emintz/FirstRobotics/PracticeFieldTimer/PracticeFieldTimer-38-pin-ESP32s2/README.md

# Generic 38 Pin ESP32 Development Board Based Countdown Timer

:warning: **DEPRECATED** :warning:

This design is deprecated and scheduled for removal. Favor the current
[ESP32 DevKitC-based](https://github.com/emintz/FirstRobotics/tree/main/PracticeFieldTimerV2)
configuration.
