emintz/FirstRobotics/PracticeFieldTimerV2/README.md

# Metuchen Momentum Countdown Timer

## License

The countdown timer hardware design is made available subject to the terms of the
CERN Open Hardware Licence Version 2 - Strongly Reciprocal. A copy should have been
provided to you. If you have not been provided with a copy, you can download one from
https://cern-ohl.web.cern.ch/ pdf
[pdf](https://gitlab.com/ohwr/project/cernohl/-/wikis/uploads/b236492596cfc91c12def7d50bbf7da0/cern_ohl_s_v2.pdf)
or
[plain text](https://gitlab.com/ohwr/project/cernohl/-/wikis/uploads/819d71bea3458f71fba6cf4fb0f2de6b/cern_ohl_s_v2.txt)
format.

## Background

The printed circuit board is a follow-on project to the prototype
countdown timer used to manage the practice field during the 2026
FIRST Mid-Atlantic championship competition. Everyone involved
considered it successful. The prototypes were immature, far too
fragile to withstand routine handling during transportation and
storage. It is hoped that the printed circuit board-based design
will meet this need.
