emintz/FirstRobotics/PracticeFieldTimerV2/PracticeFieldTimerV2.kicad_pcb

## KiCad design PracticeFieldTimerV2/PracticeFieldTimerV2.kicad_pcb (2026-06-14, an earlier design)

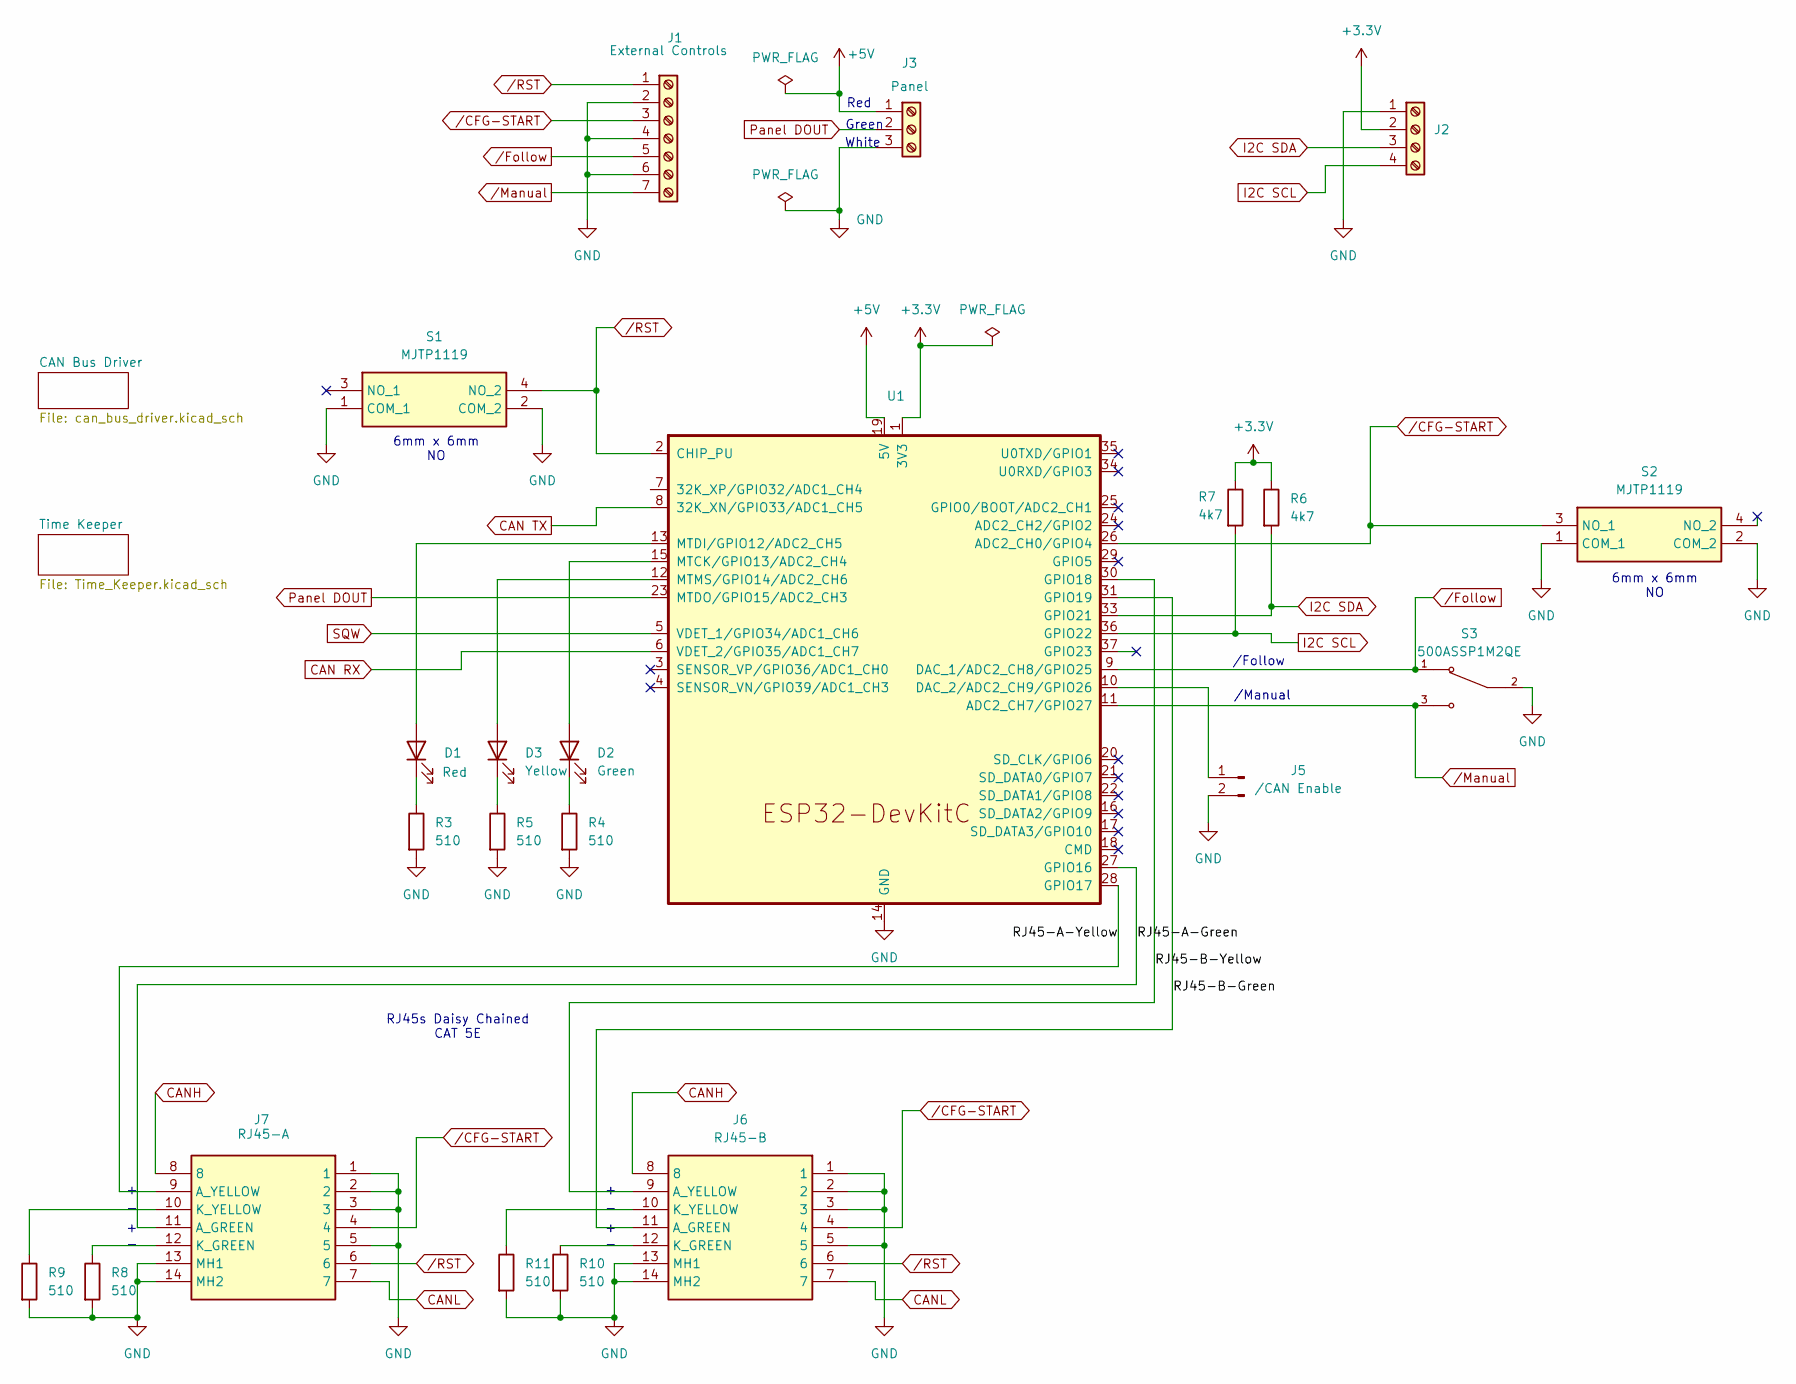
[picture p1: schematic PracticeFieldTimerV2.kicad_sch, Practice Field Timer V2 (surface mount)]

Parts:
D1: Red; LED_D5.0mm-PCBWay-Compatible
D2: Green; LED_D5.0mm-PCBWay-Compatible
D3: Yellow; LED_D5.0mm-PCBWay-Compatible
J1: External Controls; TerminalBlock_MaiXu_MX126-5.0-07P_1x07_P5.00mm
J2: Screw_Terminal_01x04; TerminalBlock_MaiXu_MX126-5.0-04P_1x04_P5.00mm
J3: Panel; TerminalBlock_MaiXu_MX126-5.0-03P_1x03_P5.00mm
J5: /CAN Enable; PinHeader_1x02_P2.54mm_Vertical
J6: RJ45-B; MTJ88TX1FSDLG; Manufacturer_Part_Number MTJ-88TX1-FSD-LG; Mouser Part Number 737-MTJ-88TX1-FSD-LG
J7: RJ45-A; MTJ88TX1FSDLG; Manufacturer_Part_Number MTJ-88TX1-FSD-LG; Mouser Part Number 737-MTJ-88TX1-FSD-LG
R3, R4, R5, R8, R9, R10, R11: 510; R_Axial_DIN0207_L6.3mm_D2.5mm_P15.24mm_Horizontal
R6, R7: 4k7; R_Axial_DIN0207_L6.3mm_D2.5mm_P15.24mm_Horizontal
S1, S2: MJTP1119; Manufacturer_Part_Number MJTP1119; Mouser Part Number 642-MJTP1119
S3: 500ASSP1M2QE; SW_500ASSP1M2QE; PARTREV G
U1: ESP32-DevKitC

Connections:
+3.3V: J2.2, R6.1, R7.1, U1.1 (3V3); also elsewhere on the board
+5V: J3.1, U1.19 (5V)
/RJ45-A-Green: J7.11 (A_GREEN), U1.27 (GPIO16)
/RJ45-A-Yellow: J7.9 (A_YELLOW), U1.28 (GPIO17)
/RJ45-B-Green: J6.11 (A_GREEN), U1.31 (GPIO19)
/RJ45-B-Yellow: J6.9 (A_YELLOW), U1.30 (GPIO18)
CAN RX: U1.6 (VDET_2/GPIO35/ADC1_CH7); also elsewhere on the board
CAN TX: U1.8 (32K_XN/GPIO33/ADC1_CH5); also elsewhere on the board
CANH: J6.8, J7.8; also elsewhere on the board
CANL: J6.7, J7.7; also elsewhere on the board
GND: J1.2, J1.4, J1.6, J2.1, J3.3, J5.2, J6.1, J6.2, J6.3, J6.5, J6.13 (MH1), J6.14 (MH2), J7.1, J7.2, J7.3, J7.5, J7.13 (MH1), J7.14 (MH2), R3.2, R4.2, R5.2, R8.2, R9.2, R10.2, R11.2, S1.1 (COM_1), S1.2 (COM_2), S2.1 (COM_1), S2.2 (COM_2), S3.2, U1.14 (GND), U1.32 (GND), U1.38 (GND); also elsewhere on the board
I2C SCL: J2.4, R7.2, U1.36 (GPIO22); also elsewhere on the board
I2C SDA: J2.3, R6.2, U1.33 (GPIO21); also elsewhere on the board
unnamed: D1.2 (A), U1.13 (MTDI/GPIO12/ADC2_CH5)
unnamed: D1.1 (K), R3.1
unnamed: D2.2 (A), U1.15 (MTCK/GPIO13/ADC2_CH4)
unnamed: D2.1 (K), R4.1
unnamed: D3.2 (A), U1.12 (MTMS/GPIO14/ADC2_CH6)
unnamed: D3.1 (K), R5.1
unnamed: J5.1, U1.10 (DAC_2/ADC2_CH9/GPIO26)
unnamed: J6.12 (K_GREEN), R10.1
unnamed: J6.10 (K_YELLOW), R11.1
unnamed: J7.12 (K_GREEN), R8.1
unnamed: J7.10 (K_YELLOW), R9.1
Panel DOUT: J3.2, U1.23 (MTDO/GPIO15/ADC2_CH3)
SQW: U1.5 (VDET_1/GPIO34/ADC1_CH6); also elsewhere on the board
/CFG-START: J1.3, J6.4, J7.4, S2.3 (NO_1), U1.26 (ADC2_CH0/GPIO4)
/Follow: J1.5, S3.1, U1.9 (DAC_1/ADC2_CH8/GPIO25)
/Manual: J1.7, S3.3, U1.11 (ADC2_CH7/GPIO27)
/RST: J1.1, J6.6, J7.6, S1.4 (NO_2), U1.2 (CHIP_PU)

Notes on the sheet:
Red
6mm x 6mm NO
Green
White
/Manual
/Follow
RJ45s Daisy Chained CAT 5E

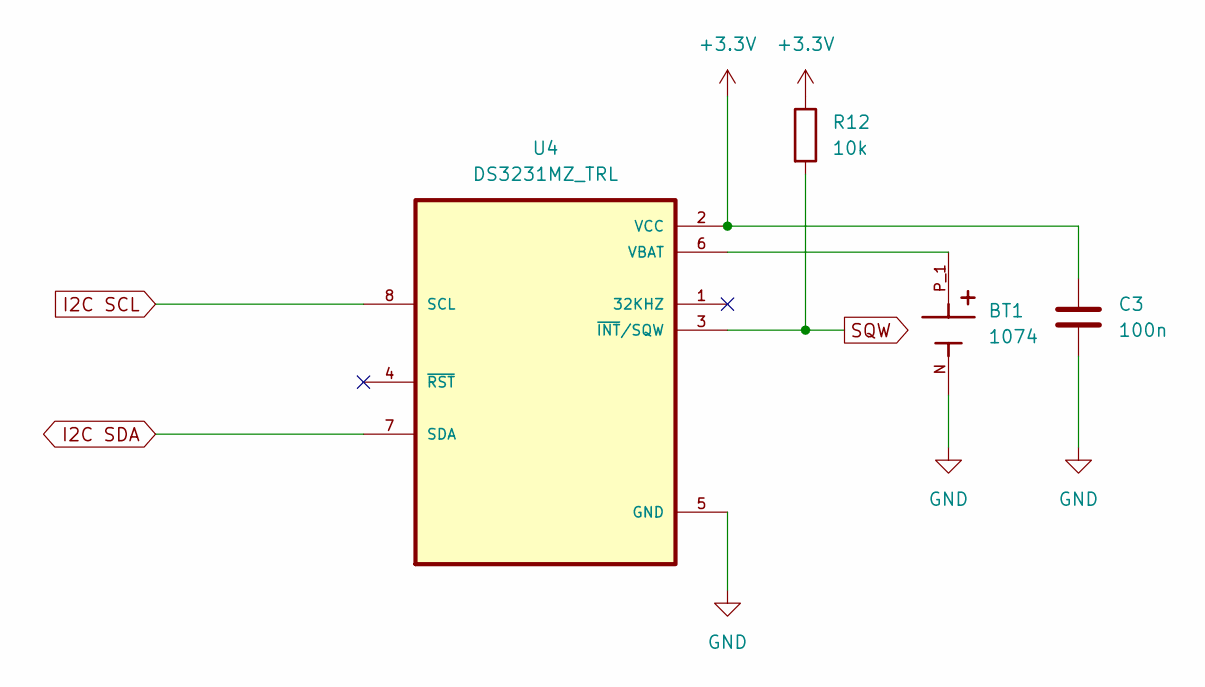
[picture p2: schematic Time_Keeper.kicad_sch, Practice Field Timer V2 (surface mount)]

Parts:
BT1: 1074; BAT_1074; PARTREV B
C3: 100n; C_Disc_D5.0mm_W2.5mm_P5.00mm
R12: 10k; R_Axial_DIN0207_L6.3mm_D2.5mm_P15.24mm_Horizontal
U4: DS3231MZ_TRL; 21-0041B_8_MXM

Connections:
+3.3V: C3.1, R12.1, U4.2 (VCC); also elsewhere on the board
GND: BT1.N, C3.2, U4.5 (GND); also elsewhere on the board
I2C SCL: U4.8 (SCL); also elsewhere on the board
I2C SDA: U4.7 (SDA); also elsewhere on the board
unnamed: BT1.P_1, BT1.P_2, U4.6 (VBAT)
SQW: R12.2, U4.3 (~INT/SQW); also elsewhere on the board

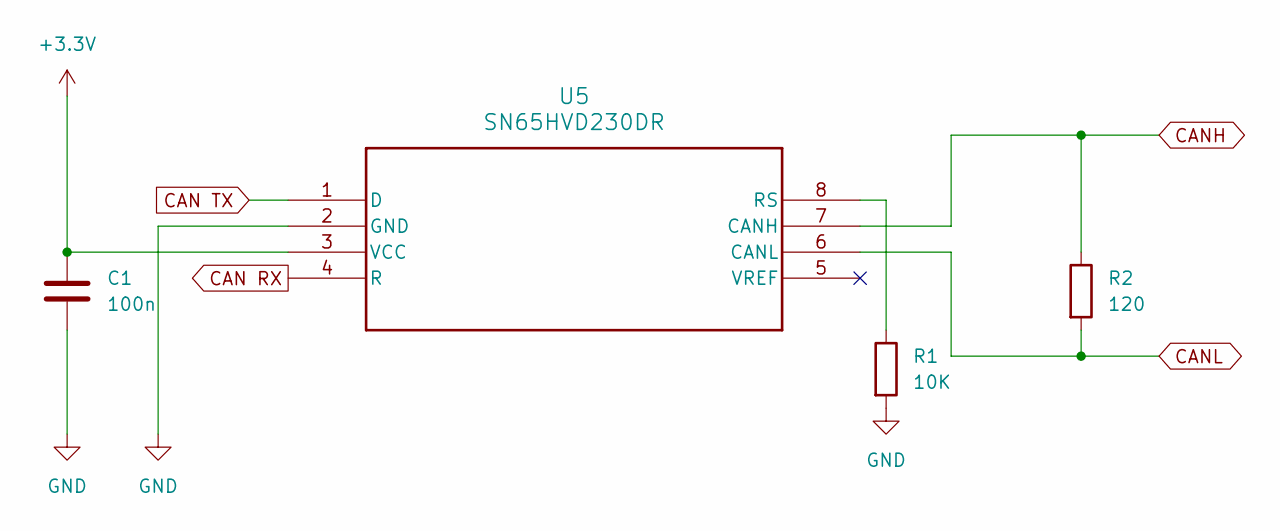
[picture p3: schematic can_bus_driver.kicad_sch, Practice Field Timer V2 (surface mount)]

Parts:
C1: 100n; C_Disc_D5.0mm_W2.5mm_P5.00mm
R1: 10K; R_Axial_DIN0207_L6.3mm_D2.5mm_P15.24mm_Horizontal
R2: 120; R_Axial_DIN0207_L6.3mm_D2.5mm_P15.24mm_Horizontal
U5: SN65HVD230DR

Connections:
+3.3V: C1.1, U5.3 (VCC); also elsewhere on the board
CAN RX: U5.4 (R); also elsewhere on the board
CAN TX: U5.1 (D); also elsewhere on the board
CANH: R2.1, U5.7 (CANH); also elsewhere on the board
CANL: R2.2, U5.6 (CANL); also elsewhere on the board
GND: C1.2, R1.2, U5.2 (GND); also elsewhere on the board
unnamed: R1.1, U5.8 (RS)

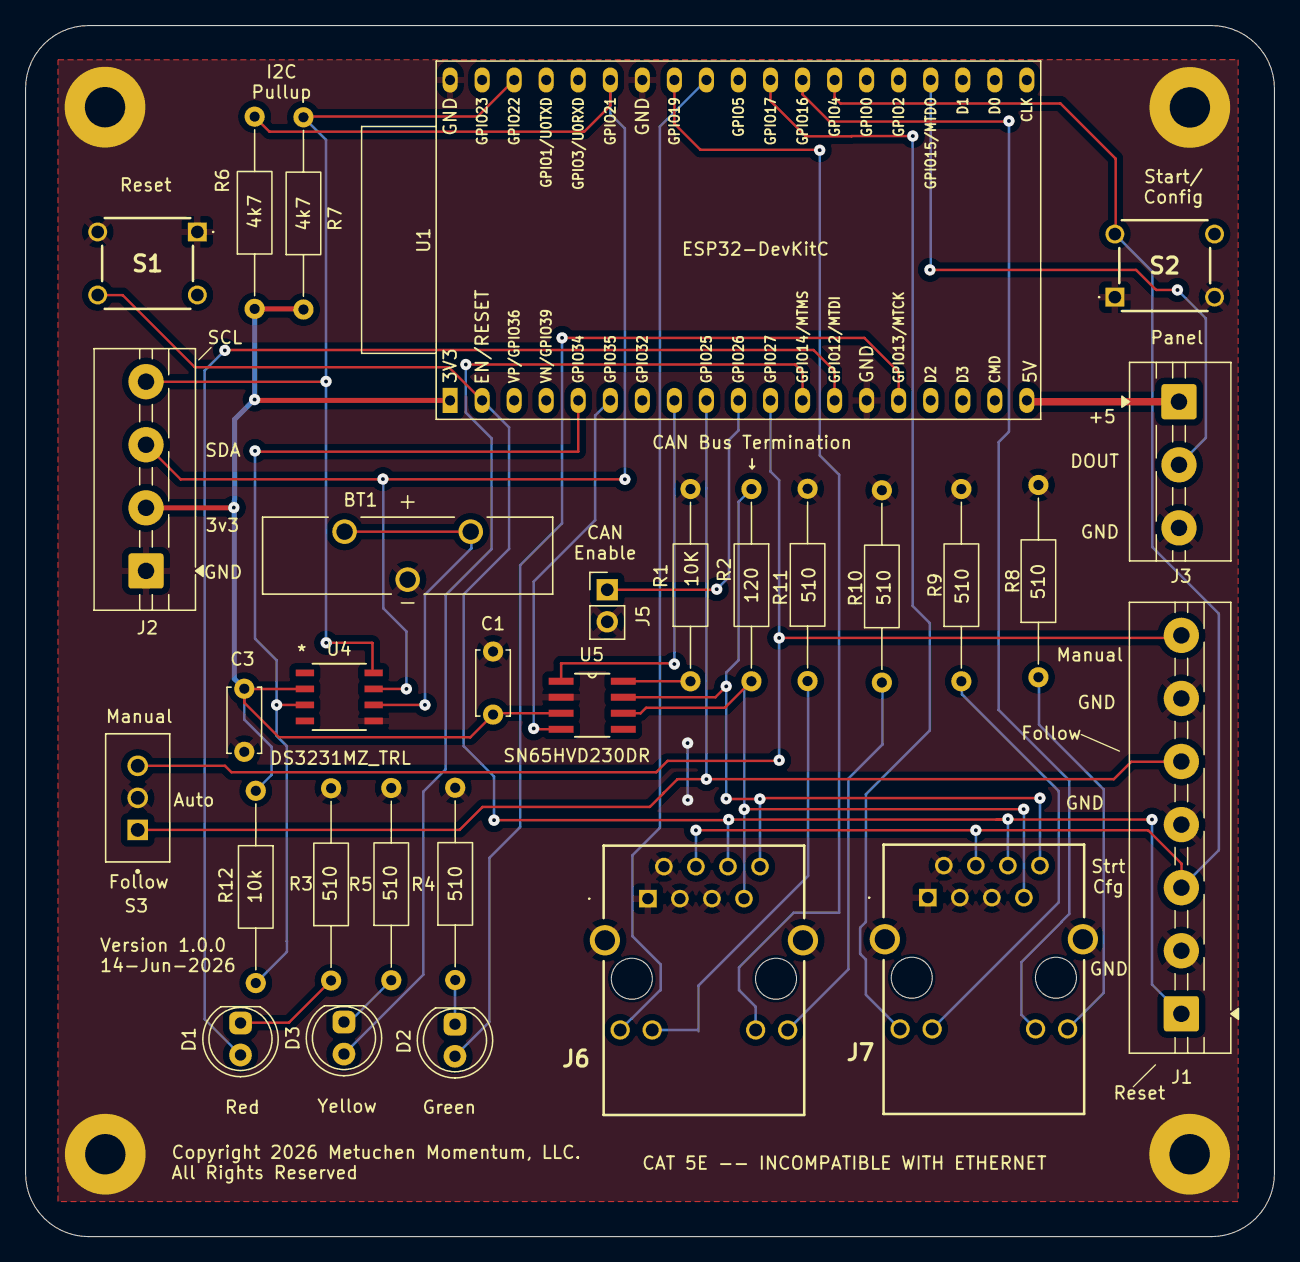
[picture p4: board PracticeFieldTimerV2.kicad_pcb from above]

Board: 2 copper layers, 99.0 x 96.0 mm, 36 parts (1 on the bottom side), 32 nets.

Other parts of the board:
Logo80%: LOGO; MetuchenMomentumLogo80Percent
MH1, MH2, MH3, MH4: MountingHole_3.2mm_M3_Pad_TopBottom_Grounded
MH3#2: (no value)

Their connections:
GND: MH1.1, MH2.2, MH3.3, MH3#2.3, MH4.4; also elsewhere on the board
