emintz/FirstRobotics/PracticeFieldTimer/src/PracticeFieldTimer.ino

/*
 * PracticeFieldTimer.ino
 *
 *  Created on: Apr 26, 2025
 *      Author: Eric Mintz
 *
 * Main program for the FIRST Robotics competition practice field.
 *
 * Copyright (C) 2025 Eric Mintz
 * All Rights Reserved
 *
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
 * You should have received a copy of the GNU Affero General Public License
 * along with this program.  If not, see <https://www.gnu.org/licenses/>.
 */
#include "Arduino.h"

#include "BlinkErrorCodes.h"
#include "CanBus.h"
#include "CANDisplayCommandPublisher.h"
#include "CanEnumerations.h"
#include "Configurator.h"
#include "ConfigurationCancelledPage.h"
#include "ContinuousCountdown.h"
#include <DataTypeCharacteristics.h>
#include "DataTypes.h"
#include "DisplayCommand.h"
#include "DS3231TimeSource.h"
#include "ErrorHalt.h"
#include "Flash32.h"
#include "ManualCountdown.h"
#include "OneShotBlink.h"
#include "PanelServer.h"
#include "PinAssignments.h"
#include "PressAndHold.h"
#include "PullQueueHT.h"
#include <SetBlankValue.h>
#include "StatusLcd.h"
#include "TaskPriorities.h"
#include "TaskWithActionH.h"
#include "TextDisplay.h"
#include "TimeChangeHandler.h"
#include "TimeRequestHandlers.h"
#include "WebServer.h"
#include "WS2812B8x32vertical.h"

#include <LiquidCrystal_I2C.h>
#include <WiFi.h>
#include <Wire.h>

#include <hal/efuse_hal.h>

// Status LCD configuration
#define LCD_ADDRESS 0x27
#define LCD_COLUMNS 20
#define LCD_ROWS 4

// User must press and hold the configuration reset button
// for three seconds within 5 seconds after power on.
#define PRESS_TIMEOUT_MS 3000
#define PRESS_WINDOW_MS 5000

// Bitmap representing "CONFIG" to be displayed
// when the web page is active.
static constexpr const uint8_t config_bitmap[] = {
//  Bits        Column
//  ----------- ------
    0b00000000, //  0

    // C
    0b01111110, //  1
    0b10000001, //  2
    0b10000001, //  3
    0b10000001, //  4
    0b01000010, //  5
    0b00000000, //  6

    // O
    0b01111110, //  7
    0b10000001, //  8
    0b10000001, //  9
    0b10000001, // 10
    0b01111110, // 11
    0b00000000, // 12

    // N
    0b11111111, // 13
    0b01000000, // 14
    0b00100000, // 15
    0b00010000, // 16
    0b11111111, // 17
    0b00000000, // 18

    // F
    0b11111111, // 19
    0b10010000, // 20
    0b10010000, // 21
    0b10010000, // 22
    0b10000000, // 23
    0b00000000, // 24

    // I
    0b11111111, // 25
    0b00000000, // 26

    // G
    0b01111110, // 27
    0b10000001, // 28
    0b10010001, // 29
    0b10010001, // 30
    0b01001110, // 31
};

// Bitmap spelling SETUP, to be displayed at power on
const uint8_t setup_bitmap[] = {
//  Bits        Column
//  ----------- ------
    0b00000000, //  0
    0b00000000, //  1

    // S
    0b01100010, //  2
    0b10010001, //  3
    0b10010001, //  4
    0b10010001, //  5
    0b01001110, //  6
    0b00000000, //  7

    // E
    0b11111111, //  8
    0b10010001, //  9
    0b10010001, // 10
    0b10010001, // 11
    0b10000001, // 12
    0b00000000, // 13

    // T
    0b10000000, // 14
    0b10000000, // 15
    0b11111111, // 16
    0b10000000, // 17
    0b10000000, // 18
    0x00000000, // 19

    // U
    0b11111110, // 20
    0b00000001, // 21
    0b00000001, // 22
    0b00000001, // 23
    0b11111110, // 24
    0b00000000, // 25

    // P
    0b11111111, // 26
    0b10010000, // 27
    0b10010000, // 28
    0b10010000, // 29
    0b01100000, // 30
    0b00000000, // 31
};

// Bitmap spelling WAIT, to be displayed after the user
// finishes configuring the timer
static constexpr const uint8_t wait_bitmap[] = {
//  Bits        Column
//  ----------- ------
    0b00000000, //  0
    0b00000000, //  1
    0b00000000, //  2
    0b00000000, //  3
    0b00000000, //  4
    0b00000000, //  5

    // W
    0b11111111, //  6
    0b00000010, //  7
    0b00000100, //  8
    0b00000010, //  9
    0b11111111, // 10
    0b00000000, // 11

    // A
    0b00111111, // 12
    0b01001000, // 13
    0b10001000, // 14
    0b01001000, // 15
    0b00111111, // 16
    0b00000000, // 17

    // I
    0b11111111, // 18
    0b00000000, // 19

    // T
    0b10000000, // 20
    0b10000000, // 21
    0b11111111, // 22
    0b10000000, // 23
    0b10000000, // 24
    0b00000000, // 25

    0b00000000, // 26
    0b00000000, // 27
    0b00000000, // 28
    0b00000000, // 29
    0b00000000, // 30
    0b00000000, // 31

};

// WiFi access point configuration
static constexpr const char *ssid = "FieldTimer";
static constexpr const char *password = "FirstRobotics";
static const IPAddress local_ip(192, 168, 251, 4);
static const IPAddress gateway(192, 168, 251, 1);
static const IPAddress subnet(255, 255, 255, 0);

// Status LCD support
static LiquidCrystal_I2C lcd(LCD_ADDRESS, LCD_COLUMNS, LCD_ROWS);
static StatusLcd status_display(lcd);

// Blinkenlights on the RJ-45 sockets
static PullQueueHT<OneShotBlinkCommand> rj45_blink_queue(3);
static OneShotBlink rj45_blink(rj45_blink_queue);
static TaskWithActionH rj45_blink_task(
    "RJ45 Blink",
    RJ45_BLINK_PRIORITY,
    &rj45_blink,
    4096);

// Time configuration.
static int32_t reference_time_utc = 0;
static int32_t auto_field_time_minutes = 0;
static int32_t manual_field_time_minutes = 0;

static int16_t time_remaining = 0;

/*
 * We want the time display to turn gradually from blue to
 * red as time elapses. We want the display to be completely
 * red for the last minute. setup() will set these constants
 * to enable this.
 */
static int16_t all_red_period = 60;

static constexpr const char *nvs_namespace = "field-timer";

static DS3231_TimeSource ds3231;
static PullQueueHT<DisplayCommand> command_queue(4);
static WS2812B8x32vertical panel;
static PanelServer server(command_queue, panel, status_display);
static TaskWithActionH server_task(
    "Panel",
    PANEL_PRIORITY,
    &server,
    4096);

static std::unique_ptr<ContinuousCountdown> continuous_count_down;
static std::unique_ptr<ManualCountdown> manual_count_down;

static TimeChangeHandler incoming_time_change_handler(
    command_queue,
    rj45_blink_queue);
static CanBus can_bus(CAN_RECEIVE_PIN, CAN_TRANSMIT_PIN, CanBusSpeed::BPS_100K);
static CANDisplayCommandPublisher to_can_bus(can_bus);
static WebServer web_server;

static void start_rj45_blink(void) {
  Serial.println("Starting RJ45 LED blink task.");
  if (rj45_blink_queue.begin()
      && rj45_blink_task.start()) {
    Serial.println("RJ45 LED blink task started.");
    return;
  }
  ErrorHalt::halt_and_catch_fire(
      RJ45_BLINK_START_FAILED,
      "RJ45 blink task start failed");
}

/**
 * Prints chip characteristics -- helpful for debugging.
 */
static void show_machine_characteristics(void) {
  uint8_t mac_address[8];
  memset(mac_address, 0, sizeof(mac_address));
  Serial.printf(
      "Chip version: %u.\n", efuse_hal_chip_revision());
  Serial.printf(
      "Block version: %u.\n", efuse_hal_blk_version());
  Serial.printf(
      "ESP32 model: %s.\n", ESP.getChipModel());
  Serial.printf(
      "The chip has %u cores.\n", ESP.getChipCores());
  efuse_hal_get_mac(mac_address);
  Serial.printf(
      "MAC address: %02x:%02x:%02x:%02x:%02x:%02x.\n",
      mac_address[0],
      mac_address[1],
      mac_address[2],
      mac_address[3],
      mac_address[4],
      mac_address[5]);
}

/**
 * Query the I2C bus for a device at the specified address on Wire
 * (bus 0).
 *
 * Parameters:
 * ----------
 *
 * Name                 Contents
 * -----------------    ------------------------------------------------
 * address              I2C address to probe
 *
 * Returns: true if an I2C device responds, false otherwise
 */
static bool have_i2c_device(uint8_t address) {
  Wire.beginTransmission(address);
  auto error = Wire.endTransmission();
  if (error == 4) {
    Serial.printf("Unknown error at 0x%2x(%d)\n",
        address, address);
  }
  return !error;
}

/**
 * Sense all attached I2C devices. The method probes the
 * bus at all valid addresses.
 */
static void scan_i2c_bus(void) {
  Serial.println("Scanning I2C bus...");
  for (uint8_t address = 1; address < 127; address++) {
    if (have_i2c_device(address)) {
      Serial.printf("I2C device found at: 0x%02x (%d decimal).\n",
          static_cast<int>(address), static_cast<int>(address));
    }
  }
  Serial.println("I2C bus scan completed.");
}

/*
 * Raises and lowers a GPIO pin 4 times/second for one second.
 * This is used during startup.
 *
 * Parameters:
 * ----------
 *
 * Name                 Contents
 * -----------------    ------------------------------------------------
 * pin                  GPIO pin to blink.
 */
static void blink_it(int pin_no) {
  for (int i = 0; i < 4; ++i) {
    digitalWrite(pin_no, HIGH);
    vTaskDelay(pdMS_TO_TICKS(125));
    digitalWrite(pin_no, LOW);
    vTaskDelay(pdMS_TO_TICKS(125));
  }
}

/*
 * Configure and turn on WIFI as an access point. This is used during
 * configuration.
 */
static void wifi_on(void) {
  if (!WiFi.mode(WIFI_AP) || !WiFi.begin(ssid, password)) {
    ErrorHalt::halt_and_catch_fire(
        WIFI_ACCESS_POINT_SETUP_FAILED,
        "Could not configure WIFI as an access_point");
  }
  if (!WiFi.softAPConfig(local_ip, gateway, subnet)) {
    ErrorHalt::halt_and_catch_fire(
        WIFI_IP_SETUP_FAILED,
        "Could not configure WIFI IP address.");
  }
}

static void clear_panel(void) {
  DisplayCommand command;
  memset(&command, 0, sizeof(command));
  command.command = DisplayCommand::Pattern::FLOOD;
  command_queue.send_message(&command);
}

static void show_wifi_setup(void) {
  status_display.clear();
  status_display.ssid(WiFi.softAPSSID().c_str());
  status_display.password(password);
  status_display.url_path(local_ip.toString().c_str());
}

/*
 * Read the configuration parameter values from the web
 * service and persist them in NVS.
 */
static void set_configuration_parameters(void) {
  digitalWrite(GREEN_LED_PIN, HIGH);
  digitalWrite(YELLOW_LED_PIN, HIGH);
  TimeRequestHandlers set_time(ds3231);
  web_server.addHandler(&set_time);
  Configurator configurator(nvs_namespace);
  std::map<const std::string, std::string> submit_attributes;
  DataTypes data_types;
  configurator
      .add_field(
          "ref-time",
          "Auto Mode Reference Time (24 Hour UTC)",
          data_types.int32)
      .add_field(
          "auto-time",
          "Auto Mode Cycle Time (Minutes)",
          data_types.int32)
      .add_field(
          "manual-time",
          "Manual Mode Cycle Time (Minutes)",
          data_types.int32);
  if (!configurator.run(web_server, "/configure-sessions")) {
    ErrorHalt::halt_and_catch_fire(
        SYSTEM_NOT_CONFIGURED,
        "Timer configuration failed.");
  }
  digitalWrite(GREEN_LED_PIN, LOW);
  digitalWrite(YELLOW_LED_PIN, LOW);
}

/*
 * Turn WiFi off -- called when configuration is complete..
 */
static void wifi_off(void) {
  if (!WiFi.mode(WIFI_OFF)) {
    ErrorHalt::halt_and_catch_fire(
        WIFI_SHUTDOWN_FAILED, "Could not turn WIFI off.");
  }
}

/*
 * Enable the configuration setup web page if the user
 * requests it by pressing and holding the
 * SET_CONFIGURATION_PIN (see PinAssignments.h) during
 * startup.
 */
static void configure_if_requested(void) {
  Serial.println("Checking for configuration request.");
  PressAndHold configuration_signal(
      SET_CONFIGURATION_PIN,
      PRESS_TIMEOUT_MS,
      PRESS_WINDOW_MS);
  if (configuration_signal.wait_for_press_and_hold()) {
    TextDisplay display;
    display(config_bitmap, {0, 0, 63}, panel);
    Serial.println("Configuring ...");
    wifi_on();
    digitalWrite(BUILTIN_LED_PIN, HIGH);
    show_wifi_setup();
    set_configuration_parameters();
    display(wait_bitmap, {31, 31, 0}, panel);
    status_display.clear();
    vTaskDelay(pdMS_TO_TICKS(2000));
    digitalWrite(BUILTIN_LED_PIN, LOW);
    wifi_off();
    panel.clear();
    Serial.println("Configuration complete.");
  } else {
    Serial.println("Configuration not requested.");
  }
}

/*
 * Read an int32 value from NVS.
 *
 * Parameters:
 * ----------
 *
 * Name                 Contents
 * -----------------    ------------------------------------------------
 * eeprom               The NVS namespace containing the configuration,
 *                      opened for read-only.
 * key                  NULL-terminated value key. Cannot be NULL or
 *                      empty.
 * value                Receives the parameter value, if found,
 *                      contents unspecified if the parameter is
 *                      missing.
 */
static void read_eeprom(
    Flash32ReadOnlyNamespace &eeprom,
    const char *key,
    int32_t *value) {
  switch (eeprom.get_int32(key, value)) {
  case Flash32Status::OK:
    break;
  case Flash32Status::NOT_FOUND:
    ErrorHalt::halt_and_catch_fire(
        INCOMPLETE_CONFIGURATION,
        "Missing configuration parameter.");
    break;
  default:
    ErrorHalt::halt_and_catch_fire(
        CORRUPT_CONFIGURATION,
        "EEPROM corrupt.");
  }
}

/*
 * Load the configuration from non-volatile storage (NVS).
 */
static void load_configuration(void) {
  Serial.println("Loading configuration.");
  if (!Flash32.begin()) {
    ErrorHalt::halt_and_catch_fire(
        NON_VOLATILE_OPEN_FAILED,
        "EEPROM open failed.");
  }
  Flash32ReadOnlyNamespace eeprom(nvs_namespace);
  if (eeprom.open() != Flash32Status::OK) {
    ErrorHalt::halt_and_catch_fire(
        CONFIG_NAMESPACE_OPEN_FAILED,
        "EEPROM namespace failed to open.");
  }
  Serial.printf("Opened \"%s\" namespace.\n", eeprom.get_name());
  read_eeprom(eeprom, "ref-time", &reference_time_utc);
  read_eeprom(eeprom, "auto-time", &auto_field_time_minutes);
  read_eeprom(eeprom, "manual-time", &manual_field_time_minutes);
  if (eeprom.close() != Flash32Status::OK) {
    ErrorHalt::halt_and_catch_fire(
        CONFIG_NAMESPACE_CLOSE_FAILED,
        "EEPROM namespace failed to close");
  }

  if (!Flash32.end()) {
    ErrorHalt::halt_and_catch_fire(
        NON_VOLATILE_CLOSE_FAILED,
        "EEPROM close failed.");
  }

  Serial.printf(
      "Reference time: %d UTC\n",
      reference_time_utc);
  Serial.printf(
      "Field time in automatic mode: %d minutes\n",
      auto_field_time_minutes);
  Serial.printf(
      "Field time in manual mode: %d minutes\n",
      manual_field_time_minutes);
}

/*
 * Create and start the continuously running automatic countdown.
 * This method should be invoked if and only if the automatic countdown
 * is configured to run.
 */
static void start_automatic_countdown(void) {
  int16_t auto_field_time_seconds = 60 * auto_field_time_minutes;
  int16_t reference_time_utc_seconds = 60 * reference_time_utc;
  continuous_count_down = std::make_unique<ContinuousCountdown>(
      SQUARE_WAVE_PIN,
      auto_field_time_seconds,
      all_red_period,
      reference_time_utc_seconds,
      command_queue,
      to_can_bus,
      rj45_blink_queue);

  int16_t sync_time_seconds =
      reference_time_utc_seconds % auto_field_time_seconds;
  int16_t rump_offset_time =
      ds3231.seconds_since_midnight() % auto_field_time_seconds;
  if (sync_time_seconds < rump_offset_time) {
    sync_time_seconds += auto_field_time_seconds;
  }
  continuous_count_down->enable(
      sync_time_seconds - rump_offset_time);
}

/*
 * Create and start the manually started countdown. This method
 * should be invoked if and only if manual countdown is configured
 * to run.
 */
void start_manual_countdown(void) {
  int16_t manual_field_time_seconds = 60 * manual_field_time_minutes;
  GpioChangeService.begin();
  manual_count_down = std::make_unique<ManualCountdown>(
      SET_CONFIGURATION_PIN,
      SQUARE_WAVE_PIN,
      manual_field_time_seconds,
      60,
      command_queue,
      to_can_bus,
      rj45_blink_queue);
  manual_count_down->start();
  clear_panel();
}

/*
 * Count the continuous countdown if the system is configured
 * to run continuously, i.e. if MANUAL_ENABLE_NOT_PIN is HIGH.
 * Note that the caller must ensure that FOLLOWER_NOT_PIN is
 * HIGH before invoking this function. Since the to MUST be
 * connected by a SPDT ON-OFF-ON switch, the harware should
 * enforce this.
 */
static void maybe_start_continuous_countdown(void) {
  if (digitalRead(MANUAL_ENABLE_NOT_PIN) == HIGH) {
    Serial.println("Starting the automatic, continuously running countdown.");
    start_automatic_countdown();
    status_display.automatic_mode();
  } else {
    Serial.println("Requesting manual countdown startup.");
    start_manual_countdown();
    vTaskDelay(pdMS_TO_TICKS(100));
    status_display.manual_mode();
  }
  vTaskDelay(pdMS_TO_TICKS(100));
}

/*
 * Initialize (i.e. load the CAN driver) and start the CAN bus.
 */
static void start_can_bus(void) {
  Serial.println("Starting CAN bus.");
  can_bus.begin();
  if (CanBusInitStatus::FAILED == can_bus.init()) {
    status_display.can_bus_status("Init Failed");
    ErrorHalt::halt_and_catch_fire(
        CAN_INIT_FAILED,
        "Can bus initialization failed.");
  }
  if (CanBusOpStatus::SUCCEEDED !=
        can_bus.start(incoming_time_change_handler)) {
    ErrorHalt::halt_and_catch_fire(
        CAN_START_FAILED,
        "Can bus startup failed.");
    status_display.can_bus_status("Start Failed");
  }
  status_display.can_bus_status("OK");
  Serial.println("CAN bus is running.");
}

/*
 * Initialize the I2C bus and start the status display
 */
static void init_i2c(void) {
  if (!Wire.begin()) {
    ErrorHalt::halt_and_catch_fire(
        I2C_STARTUP_FAILED,
        "I2C bus initialization failed.");
  }
  scan_i2c_bus();
  lcd.init();
  lcd.backlight();
  status_display.health("Setup");
}

/*
 * Start the time services. Configure the attached DS3231 to generate
 * a 1 Hz square wave. Note that the DS3231 must be calibrated to
 * UTC.
 */
static void start_time_services(void) {
  if (!ds3231.begin()) {
    ErrorHalt::halt_and_catch_fire(
        DS3231_STARTUP_FAILED,
        "DS3231 real-time clock initialization failed.");
  }

  if (!GpioChangeService.begin()) {
    ErrorHalt::halt_and_catch_fire(
        GPIO_INTERRUPT_STARTUP_FAILED,
        "GPIO change interrupt service startup failed.");
  }

  Serial.println("Timer services started.");

  int seconds_since_midnight = ds3231.seconds_since_midnight();
  int hours = seconds_since_midnight / 3600;
  int minutes = (seconds_since_midnight - hours * 3600) / 60;
  int seconds = seconds_since_midnight % 60;

  Serial.printf("Seconds since midnight: %d (%d:%d:%d UTC).\n",
      seconds_since_midnight,
      hours,
      minutes,
      seconds);
}

/*
 * Configures the timer. Automatically runs once at power on.
 */
void setup() {
  pinMode(BUILTIN_LED_PIN, OUTPUT);
  digitalWrite(BUILTIN_LED_PIN, LOW);
  pinMode(SET_CONFIGURATION_PIN, INPUT_PULLUP);
  pinMode(RED_LED_PIN, OUTPUT);
  digitalWrite(RED_LED_PIN, LOW);
  pinMode(YELLOW_LED_PIN, OUTPUT);
  digitalWrite(YELLOW_LED_PIN, LOW);
  pinMode(GREEN_LED_PIN, OUTPUT);
  digitalWrite(GREEN_LED_PIN, LOW);
  pinMode(CAN_ENABLE_NOT_PIN, INPUT_PULLUP);
  pinMode(FOLLOWER_NOT_PIN, INPUT_PULLUP);
  pinMode(MANUAL_ENABLE_NOT_PIN, INPUT_PULLUP);
  pinMode(SQUARE_WAVE_PIN, INPUT);
  pinMode(RJ45_A_YELLOW, OUTPUT);
  pinMode(RJ45_A_GREEN, OUTPUT);
  pinMode(RJ45_B_YELLOW, OUTPUT);
  pinMode(RJ45_B_GREEN, OUTPUT);

  Serial.begin(115200);
  Serial.println("Serial I/O initialized.");
  Serial.printf("Practice field timer compiled on %s at %s.\n",
      __DATE__, __TIME__);

  show_machine_characteristics();

  init_i2c();

  start_rj45_blink();

  panel.clear();
  TextDisplay text_display;
  text_display(setup_bitmap, {0, 63, 0}, panel);

  blink_it(BUILTIN_LED_PIN);
  blink_it(RED_LED_PIN);
  blink_it(YELLOW_LED_PIN);
  blink_it(GREEN_LED_PIN);
  blink_it(RJ45_B_YELLOW);
  blink_it(RJ45_B_GREEN);
  blink_it(RJ45_A_YELLOW);
  blink_it(RJ45_A_GREEN);

  if (digitalRead(FOLLOWER_NOT_PIN) == HIGH) {
    start_time_services();
    Serial.println("DS3231 started.");
  }

  configure_if_requested();

  load_configuration();

  if (!command_queue.begin()) {
    ErrorHalt::halt_and_catch_fire(
        COMMAND_QUEUE_BEGIN_FAILED,
        "Display command queue startup failed.");
  }
  Serial.println("Display command queue started.");

  server_task.start();
  Serial.println("Panel server task started.");

  if (digitalRead(CAN_ENABLE_NOT_PIN) == LOW) {
    start_can_bus();
  }

  vTaskDelay(pdMS_TO_TICKS(2000));

  /*
   * Note: FOLLOW_NOT_PIN and MANUAL_ENABLE_NOT_PIN MUST be wired
   * to the opposite side of a SPDT ON-OFF-ON switch wired to
   * ground, so at most one of them can be LOW.
   */
  if (digitalRead(FOLLOWER_NOT_PIN) == HIGH) {
    Serial.println("Configured as leader, starting countdown.");
    maybe_start_continuous_countdown();
  } else {
    status_display.follow_mode();
    clear_panel();
    vTaskDelay(pdMS_TO_TICKS(100));
    Serial.println("Configured as follower, bypassing countdown start.");
  }

  status_display.health("Running");
  Serial.println("Setup complete.");
}

/*
 * The Arduino framework repeatedly invokes loop(). Since all logic
 * runs in processes or in response to hardware interrupts, this
 * method has nothing to do, so it just waits for the longest
 * supported interval.
 */
void loop() {
  vTaskDelay(portMAX_DELAY);
}
