emintz/FirstRobotics/PracticeFieldTimer/src/ManualCountdown.h

/*
 * ManualCountdown.h
 *
 *  Created on: Jun 15, 2025
 *      Author: Eric Mintz
 *
 * A manual countdown that runs once when a specified GPIO goes
 * low. It's meant to be started manually via a mechanical switch.
 * The start signal should be debounced, but isn't at the moment.
 * TODO(emintz): debounce the start signal.
 *
 * Copyright (C) 2025 Eric Mintz
 * All Rights Reserved
 *
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
 * You should have received a copy of the GNU Affero General Public License
 * along with this program.  If not, see <https://www.gnu.org/licenses/>.
 */

#ifndef SRC_MANUALCOUNTDOWN_H_
#define SRC_MANUALCOUNTDOWN_H_

#include "Arduino.h"

#include "NotifyTaskOnPinChange.h"
#include "OneShotCountdown.h"
#include "TaskAction.h"
#include "TaskWithActionH.h"
#include "TaskNotifierVoidFunction.h"

class ManualCountdown final {

  PullQueueHT<DisplayCommand>& command_queue;
  DisplayCommandPublisher& command_publisher;
  OneShotCountdown actual_countdown;
  CountdownEnableAction countdown_enable;
  NotifyTaskOnPinChange on_pin_change;

public:
  /*
   * Constructor
   *
   * Parameters:
   * ----------
   *
   * Name                 Contents
   * -----------------    ------------------------------------------------
   * start_pin            Countdown start switch, normally HIGH. Countdown
   *                      starts when the pin goes LOW.
   * sqw_pin              Input pin for 1 Hz square wave from the time
   *                      source.
   * duration_seconds     Countdown duration in seconds, e.g. 900 for
   *                      a 15 minute countdown.
   * command_queue        Queue for sending a command to the panel
   *                      service
   * command_publisher    Publishes display events to the CAN bus if
   *                      the latter is enabled. Does nothing if the
   *                      bus is disabled.
   * rj45_led_blink       Carries commands to blink the RJ45 socket
   *                      LEDs.
   */
  ManualCountdown(
      uint8_t start_pin,
      uint8_t sqw_pin,
      int16_t duration_in_seconds,
      int16_t end_phase_seconds,
      PullQueueHT<DisplayCommand>& command_queue,
      DisplayCommandPublisher& command_publisher,
      PullQueueHT<OneShotBlinkCommand>& rj45_led_blink);
  virtual ~ManualCountdown();

  /*
   * Convenience method that runs the countdown one
   * time. Used for testing.
   */
  inline void run_one_time(void) {
    actual_countdown.enable();
  }

  /*
   * Publishes a display command to the panel server and publishes
   * it to the CAN bus, if enabled.
    *
   * Parameters:
   * ----------
   *
   * Name                 Contents
   * -----------------    ------------------------------------------------
   * command              Command to run and publish.
   */
  inline void publish(const DisplayCommand& command) {
    actual_countdown.publish(command);
  }

  inline bool start(void) {
    return on_pin_change.start();
  }
};

#endif /* SRC_MANUALCOUNTDOWN_H_ */
