emintz/FirstRobotics/PracticeFieldTimer/src/StatusLcd.cpp

/*
 * StatusDisplay.cpp
 *
 *  Created on: Jul 1, 2025
 *      Author: Eric Mintz
 *
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
 * You should have received a copy of the GNU Affero General Public License
 * along with this program.  If not, see <https://www.gnu.org/licenses/>.
 */

#include "StatusLcd.h"

#include <LiquidCrystal_I2C.h>

#define CAN_STATUS_COLUMN 7
#define CAN_STATUS_LENGTH 13
#define CAN_STATUS_ROW 1
#define MODE_COLUMN 0
#define MODE_ROW 1
#define OVERALL_HEALTH_COLUMN 0
#define OVERALL_HEALTH_LENGTH 20
#define OVERALL_HEALTH_ROW 3
#define TIME_COLUMN 7
#define TIME_ROW 0

void StatusLcd::clear_field(uint8_t column, uint8_t row, uint8_t size) {
  while (0 < size) {
    display(column + (--size), row, " ");
  }
}

size_t StatusLcd::display(uint8_t column, uint8_t row, const char *message) {
//  Serial.printf(" At (%d, %d) displaying >>>%s<<<\n", row, column, message);
  lcd.setCursor(column, row);
  return lcd.print(message);
}

StatusLcd::StatusLcd(LiquidCrystal_I2C& lcd) :
    lcd(lcd) {
}

StatusLcd::~StatusLcd() {
}

void StatusLcd::automatic_mode() {
  display(MODE_COLUMN, MODE_ROW, "Auto  ");
}

void StatusLcd::can_bus_status(const char *message) {
  clear_field(CAN_STATUS_COLUMN, CAN_STATUS_ROW, CAN_STATUS_LENGTH);
  uint8_t message_column = CAN_STATUS_COLUMN
      + display(CAN_STATUS_COLUMN, CAN_STATUS_ROW, "CAN ");
  display(message_column, CAN_STATUS_ROW, message);
}

void StatusLcd::clear(void) {
  lcd.clear();
}

void StatusLcd::follow_mode(void) {
  display(MODE_COLUMN, MODE_ROW, "Follow");
}

void StatusLcd::health(const char *message) {
  clear_field(OVERALL_HEALTH_COLUMN, OVERALL_HEALTH_ROW, OVERALL_HEALTH_LENGTH);
  display(OVERALL_HEALTH_COLUMN, OVERALL_HEALTH_ROW, message);
}

void StatusLcd::manual_mode() {
  display(MODE_COLUMN, MODE_ROW, "Manual");
}

void StatusLcd::password(const char *wifi_password) {
  size_t password_column = display(0, 1, "PW: ");
  display(password_column, 1, wifi_password);
}

void StatusLcd::ssid(const char *ssid) {
  size_t ssid_column = display(0, 0, "SSID: ");
  display(ssid_column, 0, ssid);
}

void StatusLcd::time(uint16_t time_remaining) {
  char formatted_time[10];
  uint16_t seconds = time_remaining % 60;
  uint16_t minutes = time_remaining / 60;
  memset(formatted_time, 0, sizeof(formatted_time));
  formatted_time[4] = seconds % 10 + '0';
  seconds /= 10;
  formatted_time[3] = seconds + '0';
  formatted_time[2] = ':';
  formatted_time[1] = minutes % 10 + '0';
  minutes /= 10;
  formatted_time[0] = minutes
      ? minutes + '0'
      : ' ';
//  Serial.printf("Current time: %s\n", formatted_time);
  display(TIME_COLUMN, TIME_ROW, formatted_time);
}

void StatusLcd::url_path(const char *config_ip) {
  size_t ip_column = display(0, 2, "IP: ");
  display(ip_column, 2, config_ip);
}
