emintz/FirstRobotics/PracticeFieldTimer/src/TimeChangeHandler.h

/*
 * TimeChangeHandler.h
 *
 *  Created on: Jun 9, 2025
 *      Author: Eric Mintz
 *
 * Handle incoming time change messages. This handler should
 * be active ONLY on followers. However, since a sending node
 * does not receive its own messages (under normal conditions,
 * anyway), it should be safe to run this on the leader.
 *
 * Copyright (C) 2025 Eric Mintz
 * All Rights Reserved
 *
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
 * You should have received a copy of the GNU Affero General Public License
 * along with this program.  If not, see <https://www.gnu.org/licenses/>.
 */

#ifndef TIMECHANGEHANDLER_H_
#define TIMECHANGEHANDLER_H_

#include "CanPayloadHandler.h"
#include "DisplayCommand.h"
#include "OneShotBlink.h"
#include "PullQueueHT.h"

class CanBus;
class CanPayload;

class TimeChangeHandler final : public CanPayloadHandler {
  PullQueueHT<DisplayCommand>& panel_command_queue;
  PullQueueHT<OneShotBlinkCommand>& _rj45_blink_queue;

public:

  /*
   * Constructor
   *
   * Parameters:
   *
   * Name                Contents
   * ------------------- ----------------------------------------------------
   * panel_command_queue Forwards time display commands to the panel server
   *                     for eventual, ideally prompt display
   * rj45_blink_queue    Carries the command to blink the yellow LEDS
   *                     on the RJ-45 jacks
   */
  TimeChangeHandler(
      PullQueueHT<DisplayCommand>& panel_command_queue,
      PullQueueHT<OneShotBlinkCommand>& rj45_blink_queue);
  virtual ~TimeChangeHandler();

  /*
   * Receives a time change command from the CAN bus, transforms
   * it into a semantically equivalent TimeChangePayload, the
   * command to display the time, and enqueue the result to the
   * panel command queue for eventual, ideally prompt display.
   *
   * Parameters:
   *
   * Name              Contents
   * ----------------- ------------------------------------------------------
   * bus               The CAN bus that received the payload (the incoming
   *                   command).
   * payload           The incoming time display command
   */
  virtual void operator() (CanBus& bus, CanPayload& payload);
};

#endif /* TIMECHANGEHANDLER_H_ */
