emintz/FirstRobotics/(commit log)

2025-06-08 Fix Typoz in headers.
    [NotifyFromISR.h, NotifyFunction.cpp, NotifyFunction.h]
2025-06-09 Second major code tranche: start to integrate the CAN bus.
2025-06-11 Prepare to integrate the CAN bus by decoupling the red LED from the time display and adding the required configuration pins, a CAN Enable pin to simplify debugging, and a Leader/Follower selection pi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
    Basically, both the leader and follower will nominally respect
    time display commands received on the CAN bus. However, only
    the one leader will send them and, since CAN bus nodes normally
    do not receive the messages they send, only the followers
    will receive them. The messages are sent from the time
    source, which only the leader will run.
2025-06-12 Nightly commit: Enable follower mode when FOLLOWER_NOT_PIN is LOW. Enable CAN bus when CAN_ENABLE_NOT_PIN pin is LOW. Disable time source in follower. Leader publishes time changes to CAN bus, if ena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
    Code is in rough shape and needs massive cleanup, but we now
    have a solid proof of concept.
2025-06-13 Clean up: delete unused/commented out code, delete or commment out obsolete debug prints.
2025-06-13 Document operator() and display transmit status using the red and green LEDs.
2025-06-18 Separate Leader/Follower pin from the Continuous/One Shot pin. Clear the display when manual countdown is not running. Fix bugs.
    The code needs cleanup. This is a backup by means of a commit/push.
    [DisplayDrivers.cpp, FloodPanel.cpp, FloodPanel.h, ManualCountdown.cpp, ManualCountdown.h, OneShotCountdown.cpp, OneShotCountdown.h, PanelServer.cpp]
2025-06-19 Refactor convenience display command publication. Implement it in the one shot countdown and replace the manual countdown implementation with an inline forwarder. Also change the API name to be more 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
    [ManualCountdown.cpp, ManualCountdown.h, OneShotCountdown.cpp, OneShotCountdown.h, PracticeFieldTimer.ino]
2025-06-19 Restore startup delay so as to display the test pattern on power up. Start the CAN bus (if enabled) before displaying the test pattern. This completes the prototype timer.
2025-06-22 Fix minor format violation and add a bit of logging.
    [BaseCountdown.cpp]
2025-07-08 Display WiFi settings, including the network password, on the LCD during setup. Note that security doesn't matter all that much, but it is useful to require that the configuration be set by someone w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
    [PanelServer.cpp, PracticeFieldTimer.ino, StatusLcd.cpp, StatusLcd.h]
2025-07-24 Remove unused color tracking pin definitions, as we are using an LCD to display status.
2025-08-08 Minor format fix: delete unnecessary and unwanted whitespace.
    [PanelServer.cpp]
2025-08-08 Double timer stack size to reduce overflow risk.
2025-08-08 Chain panel update with flooding. Minor format fix for clarity.
    [FloodPanel.cpp]
2025-08-08 Fix suspected race condition. Split "Leader" status into "Manual" and "Auto" depending on mode.
    [PracticeFieldTimer.ino, StatusLcd.cpp, StatusLcd.h]
2025-08-08 Remove one confusing line of debug print. Pause after displaying "Follow" in follower mode to avoid race condition or possibly to appease the Bug Demons.
    [PracticeFieldTimer.ino]
2025-12-04 Minor cleanup after failed attempt to calibrate the DS3231 from the configuration web page.
    [DS3231TimeSource.h, PracticeFieldTimer.ino, StatusLcd.h, TimeSource.cpp, TimeSource.h]
2025-12-21 Add DS3231 calibration to the configuration settings.
2025-12-21 Cosmetic fixes to web pages.
    [BypassCalibration.cpp, DisplayHomePage.cpp]
2025-12-21 Shorten the startup wait.
    [PracticeFieldTimer.ino]
2025-12-22 Replace flood panel with black with panel clear.
    [TextDisplay.cpp]
2025-12-22 Display 'WAIT' between property update and timer start. Remove unnecessary wait. Rearrange subsystem initialization to eliminate panel display artifacts.
2025-12-22 Hide the Unix time field in the time calibration landing page.
2025-12-23 Remove obsolete test pattern. We have replaced it with meaningful status messages.
    [DisplayCommand.h, DisplayDrivers.cpp]
2025-12-23 Add ESP32 breakout board pinout.
2026-01-01 Add more documentation. Blink the builtin LED at 1 Hz on success. Blink it faster on failure.
    [NetworkTime.cpp, SetDS3231.ino, WiFiConnection.cpp]
2026-01-06 Provide a stand-alone software update script. Switch from the Adafruit Real Time Clock library to the simpler version by NeiroN (neiron.nxn@gmail.com). Ignore *.bak
2026-05-08 Document the KiCad symbol for the ESP32 module uses herein.
2026-05-10 Practice Field Timer initial commit
    [PracticeFieldTimer-38-pin-ESP32s2.kicad_pcb, PracticeFieldTimer-38-pin-ESP32s2.kicad_sch, can_bus_driver.kicad_sch]
2026-05-10 Clean up and assign most footprints. Need footprint for decoupling capacitor.
    [PracticeFieldTimer-38-pin-ESP32s2.kicad_sch, can_bus_driver.kicad_sch]
2026-05-11 Finish filling in footprints.
    [PracticeFieldTimer-38-pin-ESP32s2.kicad_sch, can_bus_driver.kicad_sch]
2026-05-17 Resolved most errors. Still need to add mounting holes and define the board boundary. Also, the I2C header is way too close to the LCD and need to move. The required changes are unclear.
    [PracticeFieldTimer-38-pin-ESP32s2.kicad_pcb, PracticeFieldTimer-38-pin-ESP32s2.kicad_sch, can_bus_driver.kicad_sch]
2026-05-17 Fix LCD header, which was wired backwards.
    [PracticeFieldTimer-38-pin-ESP32s2.kicad_pcb, PracticeFieldTimer-38-pin-ESP32s2.kicad_sch]
2026-05-18 Adjust part placement and routing. Annotate the board with copyright &c. Set the edges. Next step: mounting holes.
    [PracticeFieldTimer-38-pin-ESP32s2.kicad_pcb]
2026-05-18 Add mounting holes. Note that the LCD Module mounting holes will do double duty. Label more parts and clean up a bit more.
    [PracticeFieldTimer-38-pin-ESP32s2.kicad_pcb]
2026-05-20 Move traces away from the RJ-45 jacks, which appear to have metal jackets. Add detail to annotations, correct typoz, adjust fonts.
    [PracticeFieldTimer-38-pin-ESP32s2.kicad_pcb]
2026-05-20 Set schematic size to US Letter and adjust placements to fit. Add copyright notice and team logo.
    [PracticeFieldTimer-38-pin-ESP32s2.kicad_sch, can_bus_driver.kicad_sch]
2026-05-21 Round the PCB corners, set the fill copper back from the edge, Align text, change to clear LEDs on 3-D view to avoid confusion.
    [PracticeFieldTimer-38-pin-ESP32s2.kicad_pcb]
2026-05-21 Uncross CAN Transmit and CAN Receive. They were interchanged.
    [PracticeFieldTimer-38-pin-ESP32s2.kicad_pcb, PracticeFieldTimer-38-pin-ESP32s2.kicad_sch]
2026-05-22 Print schematic on US Letter paper. Do not commit output files like Gerber and PDF.
    [PracticeFieldTimer-38-pin-ESP32s2.kicad_pcb]
2026-05-27 Exclude vestigial directory
    [DS3231_TimeSource.kicad_sch, PracticeFieldTimerV2.kicad_pcb, PracticeFieldTimerV2.kicad_sch, Status_Display.kicad_sch, can_bus_driver.kicad_sch]
2026-05-27 Fix mounting hole properties, chamfer ground plane corners, fillet (round) board edges
    [PracticeFieldTimerV2.kicad_pcb]
2026-05-28 Rearrange labels to improve appearance and legibility.
    [PracticeFieldTimerV2.kicad_pcb]
2026-05-28 Fix push button connections.
    [PracticeFieldTimerV2.kicad_pcb, PracticeFieldTimerV2.kicad_sch]
2026-05-30 Add DS3231
    [PracticeFieldTimerV2.kicad_pcb, PracticeFieldTimerV2.kicad_sch, Time_Keeper.kicad_sch]
2026-06-01 Morar blinkinlights: connect the LEDs on the RJ45 jacks to ESP32 pins. Can have too many blinkers!
    [PracticeFieldTimerV2.kicad_pcb, PracticeFieldTimerV2.kicad_sch]
2026-06-02 Mark resistors with values. Add mounting holes for the LCD display. Needlessy tweak board width.
    [PracticeFieldTimerV2.kicad_pcb]
2026-06-02 Fix traces broken in the previous commit.
    [PracticeFieldTimerV2.kicad_pcb]
2026-06-02 Clean up LCD mounting holes.
    [PracticeFieldTimerV2.kicad_pcb]
2026-06-02 More cleanup: redraw the cut lines to precise dimensions, minor improvements to symbol appearance.
    [PracticeFieldTimerV2.kicad_pcb, PracticeFieldTimerV2.kicad_sch, can_bus_driver.kicad_sch]
2026-06-03 Fix egregious wiring error in the LCD Display
    [PracticeFieldTimerV2.kicad_pcb, PracticeFieldTimerV2.kicad_sch, Status_Display.kicad_sch]
2026-06-03 Fix reversed power and ground on LCD backlight LED.
    [PracticeFieldTimerV2.kicad_pcb, PracticeFieldTimerV2.kicad_sch, Status_Display.kicad_sch]
2026-06-04 Power the LCD backlight from +5 to minimize load on the ESP32 voltage reducer and for maximum brightness.
    [PracticeFieldTimerV2.kicad_pcb, Status_Display.kicad_sch]
2026-06-09 Remove on-board LCD Module and I2C->parallel byte converter. Add terminal strip for off-board display. Shrink the board. The board is still a bit spread out, but the changes are significant enough to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
    [PracticeFieldTimerV2.kicad_pcb, PracticeFieldTimerV2.kicad_sch, Status_Display.kicad_sch, can_bus_driver.kicad_sch]
2026-06-09 Finish shrinking the board. Could do more, but the benefit doesn't justify the effort.
    [PracticeFieldTimerV2.kicad_pcb]
2026-06-09 Add missing resistors. Fix the warnings we can. Cosmetic fixes. Getting close
    [PracticeFieldTimerV2.kicad_pcb]
2026-06-10 Smush components closer together to reduce width under 100 mm because cost of manufacture. Tidied up a bit. Added missing labels. In short: mucked about.
    [PracticeFieldTimerV2.kicad_pcb]
2026-06-11 Enforce 8 Mil/.2032 mm track spacing to minimize manufacturing cost.
    [PracticeFieldTimerV2.kicad_pcb]
2026-06-11 Replace micro via with plain old via to minimize manufacturing cost and because the N00B designer doesn't understand the difference. So there!
    [PracticeFieldTimerV2.kicad_pcb]
2026-06-12 Add 10K pullup to SQW per DS3231 datasheet. Silly me!
    [PracticeFieldTimerV2.kicad_pcb, Time_Keeper.kicad_sch]
2026-06-13 Adjust traces to neaten layout a bit. Add bridge to unfilled area. Add meaningful reference codes to the mounting holes to eliminate duplicate footprint warnings.
    [PracticeFieldTimerV2.kicad_pcb]
2026-06-13 Tidy the schematic. Ground both common pins on push buttons.
    [PracticeFieldTimerV2.kicad_pcb, PracticeFieldTimerV2.kicad_sch]
2026-06-13 Minor faffing about with reference numbers.
    [PracticeFieldTimerV2.kicad_pcb]
2026-06-14 Add version number and perform final cleanup prior to requesting fab quotes.
    [PracticeFieldTimerV2.kicad_pcb]
2026-06-14 As ordered: changed mounting holes pads to through hole, minor trace adjustments, checked everything, uplocated to PCBWay. Awaiting verification so I can complete the order.
    [PracticeFieldTimerV2.kicad_pcb]
2026-06-25 Change the CAN input GPIO pin from 32, which supports input and output and provides pullup and pulldown resistors, to pin 35, an input-only pin berift of resistors, thereby freeing a full-featured GP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
    NOTE THAT THIS IS A BREAKING CHANGE. The changed software WILL NOT RUN
    on the two prototypes used at Lehigh in the spring of 2026. It will
    run on the PCB platform.
2026-06-25 Dump ESP32 chip information: core count, model name, etc. during startup. Has no other effects.
2026-06-26 Deprecate and prepare to delete the initial schematic. It won't work.
2026-06-27 Blink the RJ-45 LEDs to indicate CAN bus activity. Green signals transmission; yellow signals receipt.
