emintz/FirstRobotics/(notices)

Notices in the files:
PracticeFieldTimer/src/DisplayHomePage.cpp:
This program is free software: you can redistribute it and/or modify
it under the terms of the GNU Affero General Public License as
published by the Free Software Foundation, either version 3 of the
License, or (at your option) any later version.
PracticeFieldTimer/PracticeFieldTimer-38-pin-ESP32s2/PracticeFieldTimer-38-pin-ESP32s2.kicad_pcb:
© 2026 Metuchen Momentum, LLC. FRC Team 7587
PracticeFieldTimerV2/PracticeFieldTimerV2.kicad_sch:
Copyright 2026 Metuchen Momentum LLC
PracticeFieldTimer/PracticeFieldTimer-38-pin-ESP32s2/PracticeFieldTimer-38-pin-ESP32s2.kicad_sch:
Copyright 2026, Metuchen Momentum LLC, All Rights Reserved
